hli605-UOA/ELECTENG-311-Teamwork/README.md

# ELECTENG-311-Teamwork
ELECTENG 311 team design project focusing on power bank???
