hli605-UOA/ELECTENG-311-Teamwork/Linear Regulator/EE311_Design_Template_2026_V2 - Student_Copy.xlsx

Sheet: SS_Analysis
Linear Regulation - Part I
Linear Regulation Specifications
Parameter | Value | Unit
Max Vin(avg) | 5.00 | V
Min Vin(avg) | 0 ~ 3.5 | V
Nominal Vout(avg) | 3.50 | V
Max Pout(avg) | 0.50 | W
Min Pout(avg) | 1.75 | W
Evaluating Steady-State Operating Conditions (Theoretical)
Parameter | Value | Unit (eq) | Value | Unit (eq) | Value | Unit (eq) | Value | Unit (eq) | Value | Unit (eq)
Vout | 3.48 | V | 5.00 | V | 5.00 | V | 5.00 | V | 5.00 | V
Vin | 5.00 | V | 3.33 | V | 3.50 | V | 2.50 | V | 3.50 | V
Pout | 1.75 | W | 1.75 | W | 0.50 | W | 5.00 | W | 5.00 | W
RLoad |  | Ohms (1-8) |  | Ohms (1-8) |  | Ohms (1-8) |  | Ohms (1-8) |  | Ohms (1-8)
Iin(avg) = IL(avg) |  | A (1-10) |  | A (1-10) |  | A (1-10) |  | A (1-10) |  | A (1-10)
dIL |  | A (1-11) |  | A (1-11) |  | A (1-11) |  | A (1-11) |  | A (1-11)
DCM Achieved | Yes |  | Yes |  | Yes |  | Yes |  | Yes
Iin(pk) = IL(pk) |  | A (1-12) |  | A (1-12) |  | A (1-12) |  | A (1-12) |  | A (1-12)
Iin(rms) = IL(rms) |  | A (1-13) |  | A (1-13) |  | A (1-13) |  | A (1-13) |  | A (1-13)
Iout(avg) = ID(avg) |  | A (1-14) |  | A (1-14) |  | A (1-14) |  | A (1-14) |  | A (1-14)
ISw(rms) |  | A (1-15) |  | A (1-15) |  | A (1-15) |  | A (1-15) |  | A (1-15)
IC(rms) |  | A (1-16) |  | A (1-16) |  | A (1-16) |  | A (1-16) |  | A (1-16)
VSw(max) |  | V (1-17) |  | V (1-17) |  | V (1-17) |  | V (1-17) |  | V (1-17)
VD(max) |  | V (1-18) |  | V (1-18) |  | V (1-18) |  | V (1-18) |  | V (1-18)
dVout |  | mV (1-19) |  | mV (1-19) |  | mV (1-19) |  | mV (1-19) |  | mV (1-19)
Validating Steady-State Operating Conditions (Open-Loop Simulations)
Parameter | Value | Unit (eq) | Value | Unit (eq) |  |  | Value | Unit (eq) | Value | Unit (eq)
RLoad | 0.00 | Ohms | 0.00 | Ohms | 0.00 | Ohms | 0.00 | Ohms | 0.00 | Ohms
Operating D | #REF! |  | #REF! |  | #REF! |  | #REF! |  | #REF!
Vout |  | V |  | V |  |  |  | V |  | V
Pout |  | W |  | W |  |  |  | W |  | W
DCM Achieved
dIL |  | A |  | A |  | A |  | A |  | A
Iin(pk) = IL(pk) |  | A |  | A |  | A |  | A |  | A
Iin(rms) = IL(rms) |  | A |  | A |  | A |  | A |  | A
Iout(avg) = ID(avg) |  | A |  | A |  | A |  | A |  | A
ISw(rms) |  | A |  | A |  | A |  | A |  | A
IC(rms) |  | A |  | A |  | A |  | A |  | A
VSw(max) |  | V |  | V |  | V |  | V |  | V
VD(max) |  | V |  | V |  | V |  | V |  | V
dVout |  | V |  | V |  | V |  | V |  | V
UC3843 & PI Controller Parameters (Theoretical)
Parameter | Value | Unit (eq)
Min PI Output (Vpi_in) | 1.00 | V
Max PI Output (Vpi_in) | 4.00 | V
Vref for 5V Output | 2.50 | V
Rg | 22.00 | Ohms
Cct | 1.00 | nF
Rrt |  | kOhms
Ri |  | Ohms (1-20)
Ria |  | kOhms (1-21)
Rib |  | kOhms (1-22)
Cib |  | pF (1-23)
Rva |  | kOhms (1-24)
Rvb |  | kOhms (1-25)
Cvb |  | pF (1-26)
Rop1 | 4.70 | kOhms
Rop2 | 10.00 | kOhms
Selected Kp
Selected Ki
Validating PI Controller Operation (Closed-Loop Simulations)
Parameter | Value | Unit (eq) | Value | Unit (eq) |  |  | Value | Unit (eq) | Value | Unit (eq)
RLoad | 0.00 | Ohms | 0.00 | Ohms | 0.00 | Ohms | 0.00 | Ohms | 0.00 | Ohms
Vref | 2.50 | V | 2.50 | V | 2.50 | V | 2.50 | V | 2.50 | V
Steady State Vout |  | V |  | V |  | V |  | V |  | V
Settling Time (+/- 5%) |  | ms |  | ms |  | ms |  | ms |  | ms

Sheet: Inductor_Design
Inductor Design - Part II
Transformer Design Specifications
Parameter | Value | Unit
Selected L | #REF! | µH
Max IL(avg) | 0.00 | A
Max IL(pk) | 0.00 | A
Max RMS IL | 0.00 | A
Max Bmax | 0.25 | T
Operating fs | #REF! | kHz
Core, Former & Magnet Wire Details
Parameter | Value | Unit
Core type | EFD20
Core material | N97
Ae |  | mm^2
le |  | mm
Ve |  | mm^3
AN |  | mm^2
ln |  | mm
Wire ρ |  | Ωm
µ0 |  | H/m
µe
Achievable Kf | 0.65
Evaluating Inductor Parameters
Parameter | Value | Unit (eq)
Selected lg | 0.1 | mm
Np |  | Turns (1-1)
Bmax |  | T (1-2)
Bmax < Max Bmax | Yes
Skin Depth |  | mm (1-3)
Selected Wire Diameter | 0.5 | mm
Wire Acu |  | mm^2 (1-4)
Parallel Wires | 5
Rdc of Inductor |  | mOhms (1-5)
Max Rdc Loss in Lp |  | W (1-6)
Experimental Results
Parameter | Value | Unit (eq)
Inductance |  | uH
Bmax |  | T
Rdc |  | T
Rac |  | mOhm
