hli605-UOA/ELECTENG-311-Teamwork/Architecture_Diagram_V2.drawio.png

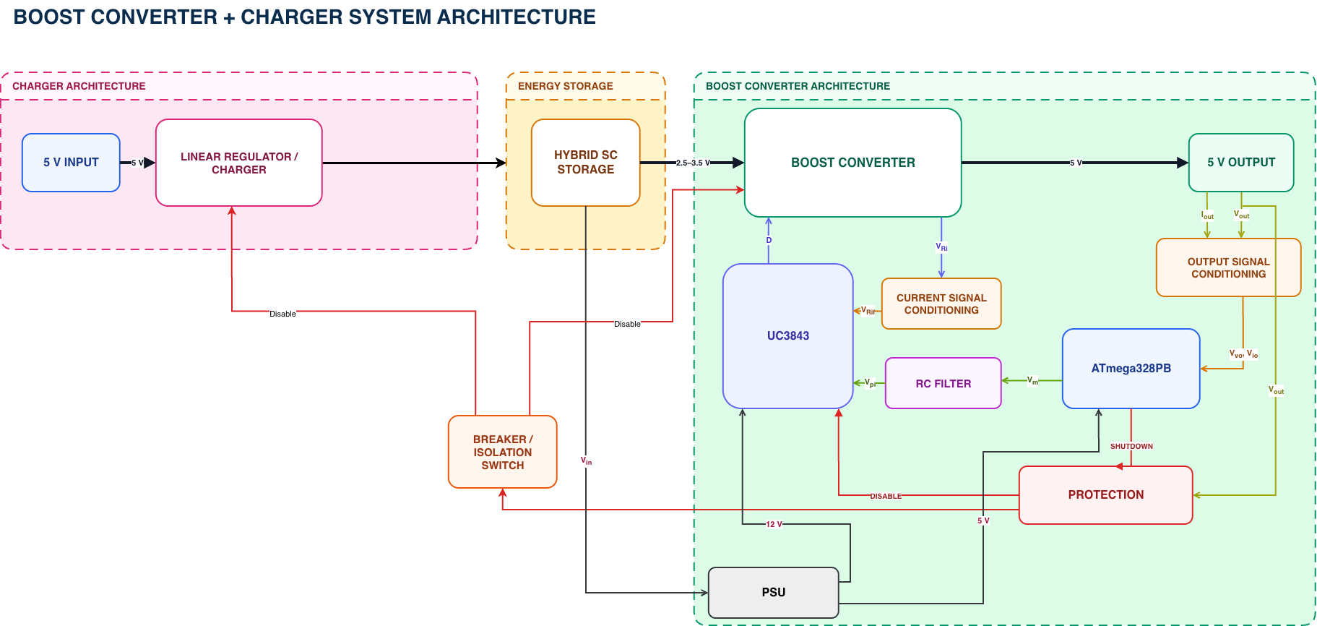
Architecture_Diagram_V2.drawio.png
