hli605-UOA/ELECTENG-311-Teamwork/Boost Converter/High_Level_Schematics.drawio.png

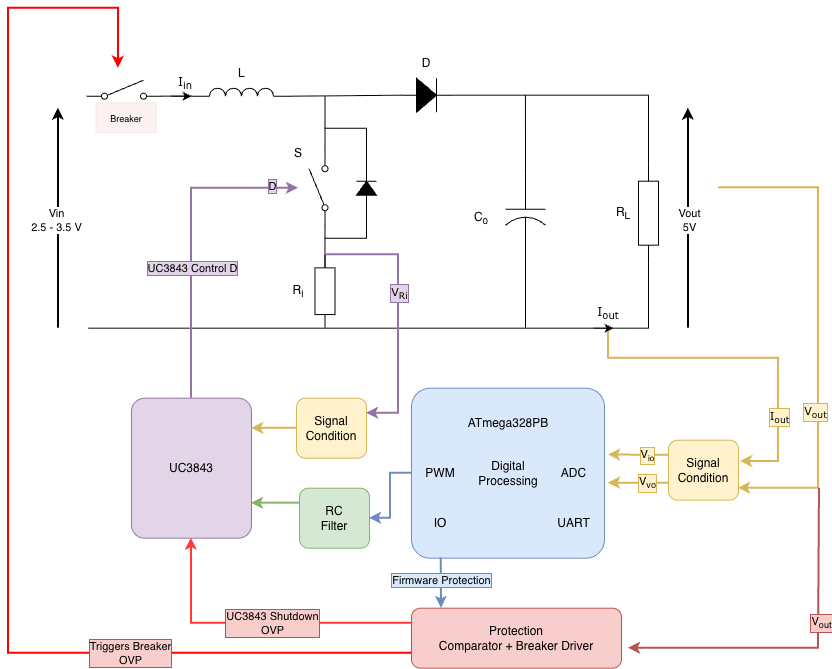
Boost Converter/High_Level_Schematics.drawio.png
