hli605-UOA/ELECTENG-311-Teamwork/Linear Regulator/Book1.xlsx

 | Purpose | Manufacturer Part | Description | Footprint | Supplier | Supplier Part Number | Acquire
1 |  | TRA000011 | TBD140 PNP Transistor TH | ECE-TO126TH | Digikey | 497-6657-5-ND | 2
2 |  |  | CAP LITHIUM HYB 30F 3.8V 8×25 | NA | Digikey | 4688-LIC0825Q3R8306-ND | 1
3 |  | CAP000520 | CAP CER 22nF 50V X7R SM0805 | ECE-CAPC2012-0805SM | Digikey | 1276-1081-2-ND | 1
4 |  | CAP000530 | CAP CER 1uF 50V X7R SM0805 | ECE-CAPC2012-0805SM | Digikey | 1276-1029-2-ND | 2
5 |  | CAP000618 | CAP CER 10nF 50V X7R SM0603 | ECE-CAPC1608-0603SM | Digikey | 399-1091-2-ND | 1
6 |  | CAP000624 | CAP CER 100nF 25V X7R SM0603 | ECE-CAPC1608-0603SM | Digikey | 399-7845-2-ND | 2
7 |  | CAP000303 | CAP 10uF 16V ELE SM | ECE-CAPAE4X5.4SM | Digikey | 493-2173-2-ND | 2
8 |  | RES000102 | RES 1R 1608 SM | ECE-RESC1608-0603SM | Digikey | 311-1.00HRTR-ND | 1
9 |  | RES000138 | RES 1kR 1608 SM | ECE-RESC1608-0603SM | Digikey | P1.00KHTR-ND | 3
10 |  | RES000145 | RES 3.9kR 1608 SM | ECE-RESC1608-0603SM | Digikey | 311-1.00HRTR-ND | 1
11 |  | RES000150 | RES 10kR 1608 SM | ECE-RESC1608-0603SM | Digikey | ECE-RESC1608-0603SM | 1
12 |  | RES000158 | RES CER 47K 1608 SM | ECE-RESC2012-0805SM | Digikey |  | 1
13 |  | TLV9162IDR | Dual 10pA 33V/us 11MHz SOIC-8 Operational Amplifier ROHS | 8-SOIC | Texas Instruments | 296-TLV9162IDRCT-ND | 1
14 |  | LM393A | Dual commercial grade standard comparator 8-SOIC -40 to 85 | N08E_TEX | Texas Instruments | 296-1398-5-ND | 1
15 |  | IRF9Z24N | MOSFET P-CH 55V 12A TO-220A | TO220AB | Digikey | IRF9Z24NPBF-ND | 1
16 |  | CON000001 | HEADER POLARISED 2WAY TH | ECE-600102STTH | Electus | HM3412 | 8
