hli605-UOA/ELECTENG-311-Teamwork/Boost Converter/Boost converter overall sheet.xlsx

Sheet: SS_Analysis
Boost Conveter Design - Part I
Boost Design Specifications
Parameter | Value | Unit
Max Vin(avg) | 3.50 | V
Min Vin(avg) | 2.50 | V
Nominal Vout(avg) | 5.00 | V
Max Pout(avg) | 5.00 | W
Min Pout(avg) | 0.50 | W
Operating fs | 100.00 | kHz
Evaluating Key Inductor Parameters for CCM (Theoretical)
Parameter | Value | Unit (eq)
Max Operating D | 0.50 | (1-1) | ## 1 - minVin/Vout
Min Operating D | 0.30 | (1-2) | ## 1 - maxVin/Vout
Max IL(avg) = Iin(avg) | 2.00 | A (1-3) | ## maxP/minVin
Min IL(avg) = Iin(avg) | 0.14 | A (1-4) | ## minP/maxVin
D for Max L for CCM | 0.33 | (1-5) | ## 0.3 < 1/3 <0.5
Max Load R | 50.00 | Ohms | ## Vo^2/Pmin
Min Load R | 5.00 | Ohms | ## Vo^2/Pmax
Min L for CCM | 37.04 | µH (1-6) | ## (Rloadmax*D*(1-D)^2)/2*fs |  |  | MinL meaning the min value we can choose - the max value the circuit will reach
Selected L | 50.00 | µH
Evaluating Output Capacitor (Theoretical)
Parameter | Value | Unit (eq)
Max Vo Ripple | 0.05 | V
Max Iout | 1.00 | A | ## Pout/Vout
Min Iout | 0.10 | A
Min Co | 100.00 | µF (1-7) | ## （Ioutmax*Dmax)/fs*ripple
Selected Co | 220.00 | µF
Evaluating Steady-State Operating Conditions (Theoretical)
Parameter | Value | Unit (eq) | Value | Unit (eq) | Value | Unit (eq) | Value | Unit (eq) | Value | Unit (eq) | Value | Unit (eq)
Vout | 5.00 | V | 5.00 | V | 5.00 | V | 5.00 | V | 5.00 | V | 5.00 | V
Vin | 2.50 | V | 3.33 | V | 3.50 | V | 2.50 | V | 3.33 | V | 3.50 | V
Pout | 0.50 | W | 0.50 | W | 0.50 | W | 5.00 | W | 5.00 | W | 5.00 | W
RLoad | 50.00 | Ohms (1-8) | 50.00 | Ohms (1-8) | 50.00 | Ohms (1-8) | 5.00 | Ohms (1-8) | 5.00 | Ohms (1-8) | 5.00 | Ohms (1-8) | ## Vout^2/Pout
Operating D | 0.50 | (1-9) | 0.33 | (1-9) | 0.30 | (1-9) | 0.50 | (1-9) | 0.33 | (1-9) | 0.30 | (1-9) | ##1 - Vin/Vout
Iin(avg) = IL(avg) | 0.20 | A (1-10) | 0.15 | A (1-10) | 0.14 | A (1-10) | 2.00 | A (1-10) | 1.50 | A (1-10) | 1.43 | A (1-10) | ## Pout/Vin
dIL | 0.25 | A (1-11) | 0.22 | A (1-11) | 0.21 | A (1-11) | 0.25 | A (1-11) | 0.30 | A (1-11) | 0.21 | A (1-11) | ## Vin*D)/(L*fs
CCM Achieved | Yes |  | Yes |  | Yes |  | Yes |  | Yes |  | Yes
Iin(pk) = IL(pk) | 0.33 | A (1-12) | 0.26 | A (1-12) | 0.25 | A (1-12) | 2.12 | A (1-12) | 1.65 | A (1-12) | 1.53 | A (1-12) | avg + delta/2
Iin(rms) = IL(rms) | 0.21 | A (1-13) | 0.16 | A (1-13) | 0.16 | A (1-13) | 2.00 | A (1-13) | 1.50 | A (1-13) | 1.43 | A (1-13) | sqrt(avg^2+delta^2/12)
Iout(avg) = ID(avg) | 0.10 | A (1-14) | 0.10 | A (1-14) | 0.10 | A (1-14) | 1.00 | A (1-14) | 1.00 | A (1-14) | 1.00 | A (1-14) | Pout/Vout
ISw(rms) | 0.15 | A (1-15) | 0.09 | A (1-15) | 0.08 | A (1-15) | 1.42 | A (1-15) | 0.87 | A (1-15) | 0.78 | A (1-15) | sqrt(D(Iavg^2 + deltaI ^2/12)) |  | only work in D period
IC(rms) | 0.11 | A (1-16) | 0.09 | A (1-16) | 0.08 | A (1-16) | 1.00 | A (1-16) | 0.71 | A (1-16) | 0.66 | A (1-16) | sqrt(Iout^2*D/1-D + (1-D)deltaI^2/12)
VSw(max) | 5.00 | V (1-17) | 5.00 | V (1-17) | 5.00 | V (1-17) | 5.00 | V (1-17) | 5.00 | V (1-17) | 5.00 | V (1-17) | VSW max = Vout | not sure for these 2
VD(max) | 5.00 | V (1-18) | 5.00 | V (1-18) | 5.00 | V (1-18) | 5.00 | V (1-18) | 5.00 | V (1-18) | 5.00 | V (1-18) | VD max = Vout
dVout | 2.27 | mV (1-19) | 1.52 | mV (1-19) | 1.36 | mV (1-19) | 22.73 | mV (1-19) | 15.18 | mV (1-19) | 13.64 | mV (1-19) | Iout D/Fs Co
Validating Steady-State Operating Conditions (Open-Loop Simulations)
Parameter | Value | Unit (eq) | Value | Unit (eq) | Value | Unit(eq) | Value | Unit (eq) | Value | Unit (eq) | Value | Unit (eq)
Vin | 2.50 | V | 3.33 | V | 3.50 | V | 2.50 | V | 3.33 | V | 3.50 | V
RLoad | 50.00 | Ohms | 50.00 | Ohms | 50.00 | Ohms | 5.00 | Ohms | 5.00 | Ohms | 5.00 | Ohms
Operating D | 0.50 |  | 0.33 |  | 0.30 |  | 0.50 |  | 0.33 |  | 0.30
Vout (mean) | 4.486 | V | 4.467 | V | 4.985 |  | 4.459 | V | 4.455 | V | 4.487 | V
Pout (rms) | 0.402 | W | 0.399 | W | 0.405 |  | 3.977 | W | 3.969 | W | 4.026 | W
CCM Achieved | Yes |  | Yes |  | Yes |  | Yes |  | Yes |  | Yes
Iin(avg) = IL(avg) | 0.171 |  | 0.133 |  | 0.129 |  | 1.784 |  | 1.330 |  | 1.282
dIL | 0.250 | A | 0.219 | A | 0.210 | A | 0.246 | A | 0.218 | A | 0.208 | A
Iin(pk) = IL(pk) | 0.303 | A | 0.242 | A | 0.233 | A | 1.907 | A | 1.439 | A | 1.386 | A
Iin(rms) = IL(rms) | 0.195 | A | 0.148 | A | 0.142 | A | 1.785 | A | 1.331 | A | 1.283 | A
Iout(avg) = ID(avg) | 0.089 | A | 0.089 | A | 0.090 | A | 0.892 | A | 0.891 | A | 0.897 | A
ISw(rms) | 0.137 | A | 0.088 | A | 0.078 | A | 1.262 | A | 0.765 | A | 0.703 | A
IC(rms) | 0.103 | A | 0.082 | A | 0.078 | A | 0.892 | A | 0.627 | A | 0.589 | A
VSw(max) | 4.997 | V | 4.970 | V | 4.999 | V | 4.973 | V | 4.963 | V | 4.994 | V
VD(max) | 4.498 | V | 4.467 | V | 4.498 | V | 4.432 | V | 4.432 | V | 4.465 | V
dVout | 0.003 | V | 0.002 | V | 0.002 | V | 0.029 | V | 0.019 | V | 0.018 | V
 |  |  | This column is to simulate the worst case Inductance Lmin
UC3843 & PI Controller Parameters (Theoretical)
Parameter | Value | Unit (eq)
Min PI Output (Vpi_in) | 1.00 | V
Max PI Output (Vpi_in) | 4.00 | V
Vref for 5V Output | 2.50 | V
Rg | 22.00 | Ohms
Cct | 1.00 | nF
Rrt | 17.20 | kOhms
Ri | 0.47 | Ohms (1-20)
Ria | 1.00 | kOhms (1-21)
Rib | 100.00 | kOhms (1-22)
Cib | 160.00 | pF (1-23)
Rva | 10.00 | kOhms (1-24)
Rvb | 10.00 | kOhms (1-25)
Cvb | 33000.00 | pF (1-26)
Rop1 | 4.70 | kOhms
Rop2 | 10.00 | kOhms
Selected Kp
Selected Ki
Validating PI Controller Operation (Closed-Loop Simulations)
Parameter | Value | Unit (eq) | Value | Unit (eq) |  |  | Value | Unit (eq) | Value | Unit (eq)
RLoad | 50.00 | Ohms | 50.00 | Ohms | 50.00 | Ohms | 5.00 | Ohms | 5.00 | Ohms
Vref | 2.50 | V | 2.50 | V | 2.50 | V | 2.50 | V | 2.50 | V
Steady State Vout |  | V |  | V |  | V |  | V |  | V
Settling Time (+/- 5%) |  | ms |  | ms |  | ms |  | ms |  | ms

Sheet: Plots
Theo VS Sim | Vout
Operating Point | Theo Vout | PLECS Vout (Open loop) | Error %
2.5V, 0.5W | 5 | 4.49 | -10.28
3.33V, 0.5W | 5 | 4.47 | -10.66
3.5V, 0.5W | 5 | 4.99 | -0.294
2.5V, 5W | 5 | 4.46 | -10.82
3.33V, 5W | 5 | 4.45 | -10.9066
3.5V, 5W | 5 | 4.49 | -10.262
Peak Inductor
Operating Point | Theo IL(pk) | PLECS IL(pk) (Open loop) | Error %
2.5V, 50Ω | 0.33 | 0.303 | -6.77
3.33V, 50Ω | 0.26 | 0.242 | -7.41
3.5V, 50Ω | 0.25 | 0.233 | -5.83
2.5V, 5Ω | 2.12 | 1.907 | -10.26
3.33V, 5Ω | 1.65 | 1.439 | -12.90
3.5V, 5Ω | 1.53 | 1.386 | -9.62
Operating Point | Theo IL(rms) | PLECS IL(rms) (Open loop) | Error %
2.5V, 50Ω | 0.21 | 0.195 | -8.29
3.33V, 50Ω | 0.16 | 0.148 | -9.62
3.5V, 50Ω | 0.16 | 0.142 | -8.43
2.5V, 5Ω | 2.00 | 1.785 | -10.80
3.33V, 5Ω | 1.50 | 1.331 | -11.49
3.5V, 5Ω | 1.43 | 1.283 | -10.25
Operating Point | Theo Vripple | PLECS Vripple (Open loop) | Error %
2.5V, 50Ω | 0.00227 | 0.00260 | 14.40
3.33V, 50Ω | 0.00152 | 0.00213 | 40.30
3.5V, 50Ω | 0.00136 | 0.00208 | 52.53
2.5V, 5Ω | 0.02273 | 0.02850 | 25.40
3.33V, 5Ω | 0.01518 | 0.01940 | 27.78
3.5V, 5Ω | 0.01364 | 0.01800 | 32.00

Sheet: BOM
Boost Converter Stage | Type | Purpose
L1 | Custom wound Inductor | Main boost energy storage
Q1 | N-channel MOSFET | switching for 100khz | 13 | MOSFET | IRFZ46NPBF | N-Channel 55 V 53A (Ta) | TO220 | Digikey | IRFZ46NPBF-ND
D1 | Schottky diode | boost rectifier diode | 37 | Schottky diode | SSA34-E3/61T | DIODE SCHOTTKY 40V 3A DO214 | DO214 | Digikey | SSA34-E3/61TGITR-ND
R5 | shunt resistor | Measures mosfet and inductor current for feedback | https://www.digikey.com/en/products/detail/riedon-products-by-bourns/UB5C-0R33F1/2176622
R2 | MOSFET gate resistor | Controls gate switching speed
R3 | MOSFET gate sourse pull down resistor | Keeps MOSFET OFF when gate is undriven
C1 | Bulk polarized input capacitor | reduces low-frequency input ripple
C3,C4 | Decoupling Capacitor | High frequency filtering, provide low impedance path for switching frequency noise
C2 | Output Capacitor | Stores Energy and reduces output voltage ripple | 6 | Bulk electrolytic capacitors - choice 2 | UCL1V221MNL1GS | 220 µF 35 V Alum, 80mOhm @ 100kHz 2000 Hrs @ 105°C | CR08 | Digikey | 493-3957-2-ND
C5,C6 | Decoupling Capacitor | High frequency filtering, provide low impedance path for switching frequency noise
UC3843 PWM Controller
Section | Schematic refs | Generic component type | Purpose
1. Boost power stage | L1 | Power inductor / custom wound inductor | Main boost energy-storage inductor
 | Q1 | N-channel power MOSFET | Main 100 kHz switching device
 | D1 | Power Schottky diode | Boost rectifier diode
 | R5 | Low-value current-sense / shunt resistor | Measures MOSFET/inductor current
 | R2 | MOSFET gate resistor | Controls gate switching speed/ringing
 | R3 | MOSFET gate-source pull-down resistor | Keeps MOSFET OFF when gate is undriven
2. Input/output power capacitors | C1 | Bulk polarized input capacitor | Low-frequency input energy buffering
 | C3, C4 | Ceramic input bypass/ripple capacitors | High-frequency switching current filtering
 | C2 | Bulk polarized output capacitor | Output energy storage / low-frequency ripple
 | C5, C6 | Ceramic output bypass/ripple capacitors | High-frequency output ripple filtering
3. UC3843 PWM controller | U1 | UC3843 current-mode PWM controller IC | Generates MOSFET gate PWM
 | C15, C16 | 10 V supply decoupling/bulk capacitors | UC3843 VCC decoupling
 | C10 | Ceramic VREF decoupling capacitor | Stabilises UC3843 5 V reference
4. UC3843 oscillator / switching-frequency setting | R18 | Timing resistor | Sets UC3843 oscillator frequency
 | C11 | Timing capacitor | Sets UC3843 oscillator frequency
5. Current-feedback signal conditioning | U2B | Op-amp current-sense amplifier / signal conditioner | Amplifies/conditions voltage from R5
 | R11, R12, R14 | Signal-conditioning resistors | Input scaling/filtering
 | R6, R8 | Op-amp gain-setting resistors | Set current feedback amplifier gain
 | C7, C8 | Small-signal ceramic filter/compensation capacitors | Remove switching noise / control bandwidth
 | R10 | Slope-compensation injection resistor | Adds slope-compensation ramp to current feedback
6. Slope-compensation generator | Q2 | Small-signal BJT transistor | Generates/conditions oscillator ramp
 | D2 | Small-signal switching diode | Directs slope-compensation signal
 | R23 | Small-signal resistor | Bias/discharge path
 | C13 | Small-signal ceramic capacitor | AC coupling / ramp shaping
7. MCU PI → UC3843 control interface | R17, R19, R20, R21 | Small-signal / control-loop resistors | Scale and interface MCU PI command with UC3843
 | C9 | Compensation capacitor | UC3843 COMP/VFB control-loop compensation
 | C12 | Ceramic RC-filter capacitor | Filters MCU PI/control signal
8. Output-voltage sensing for MCU | R22, R24 | Precision voltage-divider resistors | Scales 5 V output to MCU ADC range
 | C14 | Ceramic anti-alias / ADC filter capacitor | Filters 100 kHz switching ripple before MCU ADC
9. Reference / OVP conditioning | U2A | Op-amp voltage buffer/reference circuit | Produces conditioned reference Vo
 | R13, R15 | Precision voltage-divider resistors | Creates reference voltage from 5 V
 | R16 | Op-amp feedback resistor / link | Configures U2A
 | C17 | Op-amp supply decoupling capacitor | 10 V supply decoupling
10. Hardware over-voltage shutdown | Q3 | Small-signal BJT transistor | Pulls UC3843 COMP low during OVP
 | R7 | BJT base-current limiting resistor | Interfaces OVP signal to Q3
11. Connectors & debugging | CON1 | 2-pin power input connector | Battery/supercapacitor input
 | CON2 | 2-pin power output connector | 5 V output
 | J1 | 3-pin header | Vbat / GND / 10 V
 | P3 | 2×10 pin header | MCU/smart-feature interface
 | P4 | 2-pin header | Vbat / GND connection
 | TPxx | Through-hole test points | Debugging and measurements

Sheet: Inductor_Design
Inductor Design - Part II
Transformer Design Specifications
Parameter | Value | Unit
Selected L | 50.00 | µH
Max IL(avg) | 2.00 | A
Max IL(pk) | 2.12 | A
Max RMS IL | 2.00 | A
Max Bmax | 0.25 | T
Operating fs | 100.00 | kHz
Core, Former & Magnet Wire Details
Parameter | Value | Unit
Core type | EFD20
Core material | N97
Ae | 31.00 | mm^2
le | 47.00 | mm
Ve | 1460.00 | mm^3
AN | 28.10 | mm^2
ln | 40.20 | mm
Wire ρ | 1.7241e-08 | Ωm
µ0 | 1.256637061e-06 | H/m
µe | 1510
Achievable Kf | 0.50
Evaluating Inductor Parameters
Parameter | Value | Unit (eq)
Selected lg | 0.1 | mm
Np | 17.22358145 | Turns (1-1)
Bmax | 0.199 | T (1-2)
Bmax < Max Bmax | Yes
Skin Depth | 0.209 | mm (1-3)
Selected Wire Diameter | 0.418 | mm
Wire Acu | 0.137 | mm^2 (1-4)
Current density without Np | 14.587 | A/mm^2
Parallel Wires | 5
Current density J | 2.917 | A/mm^2
Rdc of Inductor | 17.402 | mOhms (1-5)
Max Rdc Loss in Lp | 69.70 | mW (1-6)
Experimental Results
Parameter | Value | Unit (eq)
Inductance |  | uH
Bmax |  | T
Rdc |  | T
Rac |  | mOhm
