hli605-UOA/ELECTENG-311-Teamwork/(list of files, drawings)

Other design files:
Altium/All_Components/infineon-pcb-footprints-and-symbols-irf9z24n-p-channel-altium-pcbdesigndata-en/IFX-PG-TO220-3-904-1.PcbLib
Altium/All_Components/infineon-pcb-footprints-and-symbols-irf9z24n-p-channel-altium-pcbdesigndata-en/IRF9Z24N.SchLib
Altium/All_Components/LIB_1N4148W-13-F_Altium/1N4148W-13-F.SchLib
Altium/All_Components/LIB_1N4148W-13-F_Altium/SOD3716X145N.PcbLib
Altium/All_Components/LIB_BAT46W-7-F_Altium/BAT46W-7-F.SchLib
Altium/All_Components/LIB_BAT46W-7-F_Altium/SOD3716X145N.PcbLib
Altium/All_Components/LIB_CL32B106KBJNNNE_Altium/CAPC3225X270N.PcbLib
Altium/All_Components/LIB_CL32B106KBJNNNE_Altium/CL32B106KBJNNNE.SchLib
Altium/All_Components/LIB_GRM31C5C2A104JA01L_Altium/CAPC3216X180N.PcbLib
Altium/All_Components/LIB_GRM31C5C2A104JA01L_Altium/GRM31C5C2A104JA01L.SchLib
Altium/All_Components/LIB_LM4040C25FTA_Altium/LM4040C25FTA.SchLib
Altium/All_Components/LIB_LM4040C25FTA_Altium/SOT96P240X110-3N.PcbLib
Altium/All_Components/LIB_TLV9162IDR_Altium/SOIC127P600X175-8N.PcbLib
Altium/All_Components/LIB_TLV9162IDR_Altium/TLV9162IDR.SchLib
Altium/All_Components/LIB_TPS22917DBVR_Altium/SOT95P280X145-6N.PcbLib
Altium/All_Components/LIB_TPS22917DBVR_Altium/TPS22917DBVR.SchLib
Boost Converter/PR3/atmega328 proteus/ATmega328P_simulation.pdsprj
Boost Converter/PR3/atmega328 proteus/Project Backups/ATmega328P_simulation [20260928, 23-07-51].pdsprj
Boost Converter/PR3/atmega328 proteus/Project Backups/ATmega328P_simulation [20260928, 23-07-53].pdsprj
Boost Converter/PR3/atmega328 proteus/Project Backups/ATmega328P_simulation [20261002, 18-25-23].pdsprj
Boost Converter/PR3/atmega328 proteus/Project Backups/ATmega328P_simulation [20261002, 18-31-28].pdsprj
