hli605-UOA/ELECTENG-311-Teamwork/(commit log)

2026-07-28 Create Linear Regulator
2026-07-28 Add file - Linear Regulator without compensation
2026-07-28 Add Current limiting
    Add New BJT and R3
2026-08-03 Add Boost converter schematic and simulation
2026-08-13 Add design template_Boost Converter
    Complete first part of theoretical
    [Boost Converter Design.xlsx]
2026-08-13 Upload boost converter simulation for progress review 2
    update file names
    [Boost_Converter _Design_PR2.xlsx]
2026-08-17 Complete Open loop Simulation
    update excel file
    [Boost_Converter _Design_PR2.xlsx, Boost_Converter_Design_PR2_v2.xlsx]
2026-08-20 Altium Components
    [1N4148W-13-F.SchLib, BAT46W-7-F.SchLib, CAPC3216X180N.PcbLib, CAPC3225X270N.PcbLib, CL32B106KBJNNNE.SchLib, GRM31C5C2A104JA01L.SchLib, IFX-PG-TO220-3-904-1.PcbLib, IRF9Z24N.SchLib]
2026-08-20 Add files via upload
    Linear-Regulator excel sheet
    [EE311_Design_Template_2026_V2 - Student_Copy.xlsx]
2026-08-22 update BOM, inductor calculation and plots
    [Boost converter overall sheet.xlsx, Boost_Converter_Design_PR2_v2.xlsx]
2026-08-22 BOM for Regulator
    [Book1.xlsx]
2026-08-23 BOM update
    [Book1.xlsx]
2026-09-28 update proteus and microchip studio simulation
    [ATmega328P_simulation [20260928, 23-07-51].pdsprj, ATmega328P_simulation [20260928, 23-07-53].pdsprj, ATmega328P_simulation.pdsprj]
2026-10-02 Complete Proteus Simulation
    [ATmega328P_simulation [20261002, 18-25-23].pdsprj, ATmega328P_simulation [20261002, 18-31-28].pdsprj, ATmega328P_simulation.pdsprj]
